wraith-chip/wraith-oss/docs/report.pdf

# WRAITH: A Resource-Efficient Dataflow Accelerator

ECE 427 Final Report

Prakhar Gupta
prakhar7@illinois.edu

Ingi Helgason
ingih2@illinois.edu

Pradyun Narkadamilli
pradyun2@illinois.edu

Sam Ruggerio
samuelr6@illinois.edu

Abstract—This work presents WRAITH, a compute substrate built on TSMC 65nm process that attempts to exploit available TLP and DLP in a power-efficient manner by colocating a set of “virtual” RISC-V processors and a dataflow accelerator on a shared datapath, as well as its bringup process.

I. PROJECT SUMMARY
A. Main Features
WRAITH contains a compute substrate consisting of 16 Processing Elements (PEs), arranged as a 4x4 2D mesh. 8 of these PEs are configured with 32-bit multipliers and 8 are configured with 32-bit ALUs (supporting most standard RISC-V ALU operations). Each PE can support up to 14 unique actions. A 2x2 subcluster PEs share a register file, with banked writes and all-way reads. There are two “scratchpad” banks, each 2KB, which hold the input and output results of kernel data respectively.
Two 5-stage RISC-V cores, implementing RV32IM are located near the compute substrate. Each core has a pipelined, 2KB, direct-mapped, shared I/D-cache. These cores utilize the compute mesh interface to perform multiplication. Provided the mesh is configured to handle RISC-V multiplications, this action can be performed even if the compute mesh is currently processing a kernel. These RISC-V cores share a 6-cycle 32-bit divider to fully implement the M specification.
All elements of WRAITH are managed by the Mesh and Memory Management Unit (MMMU). The MMMU handles a 32-bit tri-state bus from an off-chip controller and responds to memory requests from the RISC-V cores. When the off-chip controller is ready to utilize the mesh, it utilizes a cooperative protocol to receive the kernel for the mesh, along with the kernel input data itself. The MMMU also handles CSR read and write requests to inspect the functional state of the chip. WRAITH fits onto a 1mm²
square tile using a 65nm
process. It can support clock speeds up to 500MHz from an external clock, with some test features limited to 200MHz.
B. High-Level Architecture
The WRAITH architecture is depicted in Figure 1. At the center is a CGRA-like mesh of processing elements (PEs). Typical CGRA architectures tend to follow the ADRES [1] scheme, where each PE has a separate PC and executes its own program stored in a private configuration RAM. Care must be taken in the configuration to ensure cycle-by-cycle correctness during execution.
By contrast, WRAITH adopts a reactionary model for its mesh. Rather than operating on a sequential program, PEs

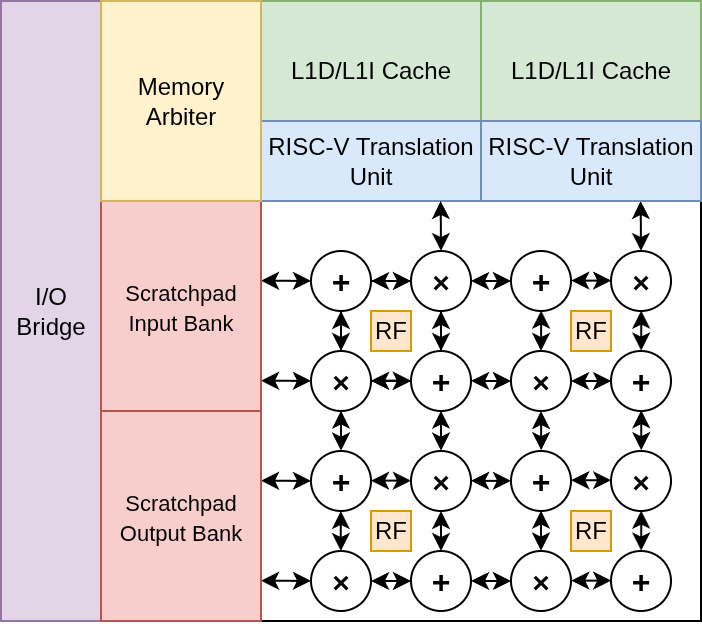
[picture p1: figure]

Fig. 1. WRAITH Architectural Diagram

instead generate responses to packets received from any of their neighboring nodes. The protocol for doing so is described in section IV-B. Both execution and configuration tasks for a PE are initiated by sending it a packet, meaning WRAITH’s mesh does not need any explicit control logic.
Control logic is instead managed by two controller peripherals, the MMMU and a Scratchpad Memory controller. These blocks work together to format input data and requests into a format ingestible by the ingress ports of the mesh.
Below, we give more detailed architectural descriptions of the various components utilized by WRAITH.
Processing Elements: Each processing element is a 3-stage pipeline which takes an input packet from a 2-depth FIFO, performs an operation, and generates an output packet to a 2-depth FIFO. See Figure 2 for a high level diagram.
The PE supports basic forwarding to mitigate data hazards, and has stall controls if the destination egress FIFO is full during operation. The multiplier supports 32-bit signed and unsigned multiplication, compliant with the RISC-V M specification. The ALU supports all standard RV32I operations except for slt and srl.
Each PE is connected to up to 4 adjacent PEs, with boundary PEs being connected to either the input/output scratchpad banks or the RISC-V cores for multiplication. The layout is a checkerboard of ALU and Multiplier PEs.
RISC-V Translation Units: WRAITH is equipped with two RISC-V “Translation Units” (RVTU). Each RVTU is a stan-

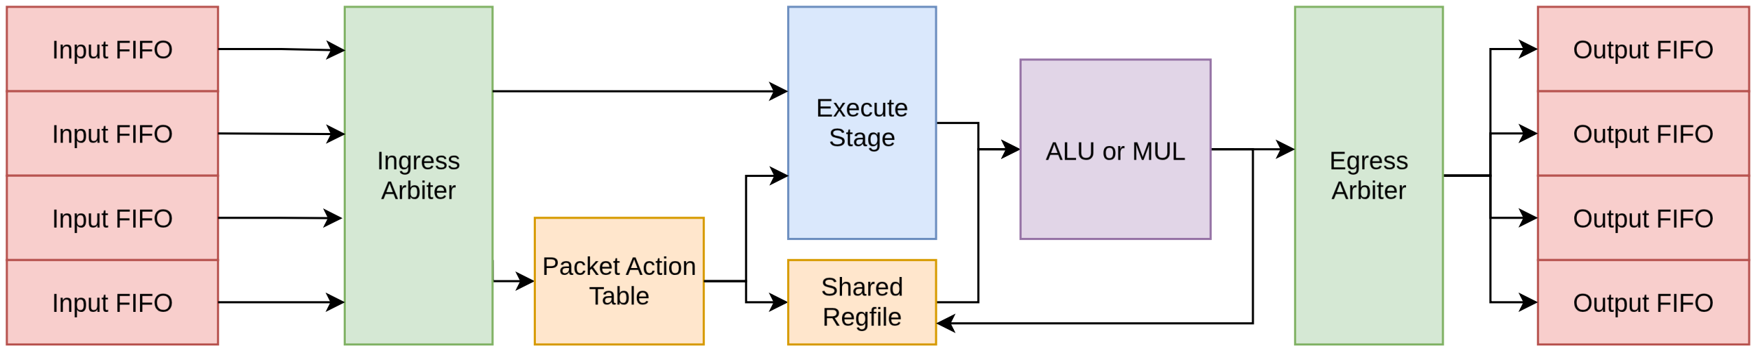
[picture p2: figure]

Fig. 2. Processing Element Pipeline

dard 5-stage pipeline core implementing RV32IM. However, in the Execute stage, a multiplication µOP is translated into two packets compliant with our mesh architecture. These packets are injected into the mesh and the RVTU awaits a response. This is our main proof of concept to show viable reuse of the compute mesh during low utilization. For completeness of the M specification, we included a 6-cycle 32-bit divider that is shared between the two RVTUs. See Figure 3 for the modified execute stage and shared cache changes.
Each RVTU has a pipelined, 2KB, direct-mapped, shared I/D-cache. These caches do not support triggered cacheflushes, as it is expected that this is done in software due to their small size. The user is expected to keep the memory sections of each RVTU’s program separate to avoid collision, as caches are not coherent.
Each RVTU also has a dedicated IO reset pin, and a halt CSR to indicate program completion. The reset pin also serves as a disable pin of sorts, as the RVTU will not emit any requests to any shared resources if it is held high. Scratchpad Banks: WRAITH contains two 2KB banks which handle input and output kernel data between the off-chip controller and the compute mesh. The off-chip begins a request by setting up CSRs to tell the scratchpad controller which PE to send and expect data from, how many packets are being set, and what PID should be used when sending the packets into the mesh. Kernels can operate on up to 512 32-bit words.
By default, the scratchpad controller is responsible for adding the PID to the input data, which determines whether the mesh is being configured or utilized. There is an alternative mode to reduce the bit-depth of the packet payload and include mixed-PIDs in the 32-bit word.
Once the scratchpad controller has received the correct number of packets, the off-chip controller can trigger a writeback to flush the output scratchpad bank. Provided that the kernel does not require pre-loaded constants each run, once the mesh is programmed once, the off-chip controller can send multiple cycles of data in succession.
Mesh and Memory Management Unit: The MMMU handles the memory requests from the RVTUs, the scratchpad banks, and the off-chip controller in a cooperative protocol. The MMMU controls a 32-bit tristate bus, polling specific pins to receive requests from off-chip. The MMMU contains an arbiter which manages bus access contention between the RISC-V cluster, the CSR file and the scratchpad banks.

Additionally, the MMMU manages two sets of CSR register files: one written to by on-chip and read by off-chip, and one read by on-chip and written to by off-chip. CSR requests are given priority over kernel operations, which is given priority over RVTU requests.

C. Physical Design
WRAITH utilizes a 1mm²
tile using TSMC’s 65nm process. There is a single clock domain which drives both the IO ring and internal modules. WRAITH supports clock speeds up to 500MHz, with some testing features limited to 200MHz. The standard IO ring allots a 820 × 820µm core area. We were able to expand our core area to 844 × 844µm with four 34×34µm triangular corners blocked for place and route. This increased our usable area to 710024µm²

from 672400µm²
Before filling, we utilize 547602µm²
core area, resulting in
77% density. A general view of our physical design can be seen in Figure 4, while the triangular blockage we used can be seen in Figure 5.
Our estimated power usage at a 500MHz clock, with a 1.0V core voltage:
- 158.4mW Internal Power
- 122.9mW Switching Power
- 255.2mW Leakage Power¹

Our IO utilization is as follows, for a total of 52 pins:
- 32 pins for the inout tri-state bus
- 2 pins for RVTU resets
- 6 pins for Scratchpad Bank “fallback” mode
- 3 pins for inspecting the IO Bridge FSM state
- 1 pin for power indication
- 2 pins for clock & reset
- 6 pins for power & ground pairs.
D. Design Choices

Reactive Mesh Architecture. CGRAs which adhere to the ADRES architecture [1] have a configuration RAM in each processing element to determine what operation to do next. Although this allows for more complex data orchestration paradigms, it would have been infeasible to implement in an area-efficient manner within the time constraints. Our reactionary model vastly simplifies implementation details and routing overhead, albeit at the cost of scheduling flexibility.

1This does not include leakage induced by our register file IP blocks, as the analysis reports 42W of leakage, which is erroneous.

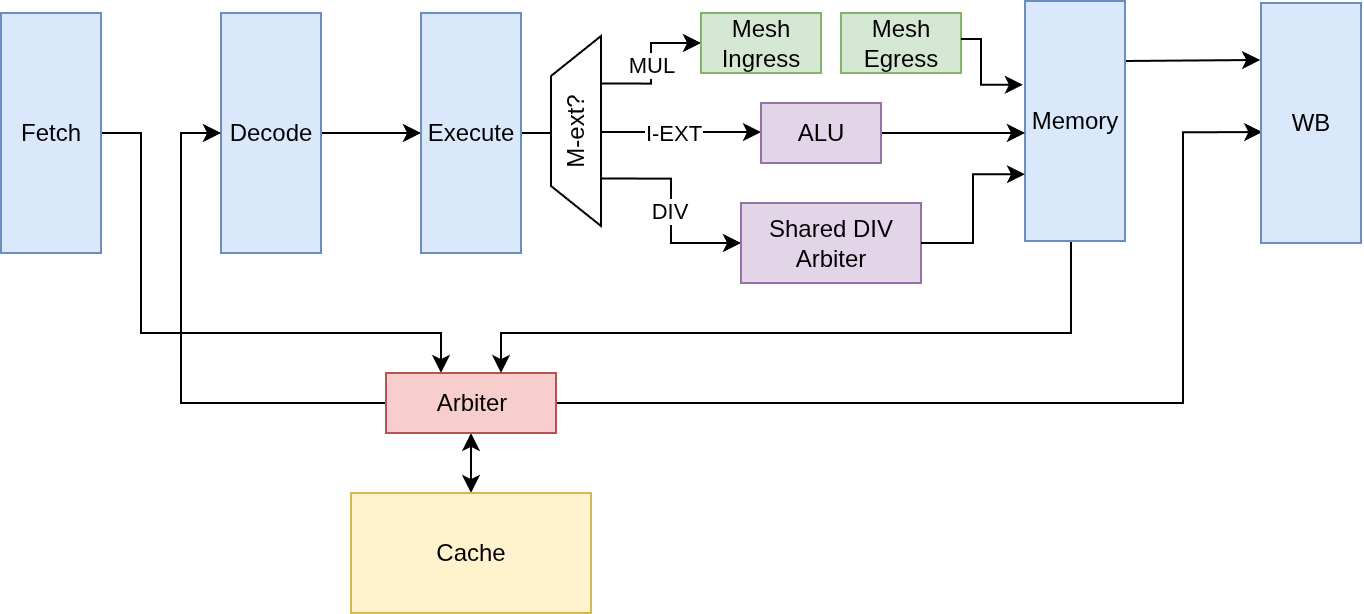
[picture p3: figure]

Fig. 3. RISC-V Translation Unit

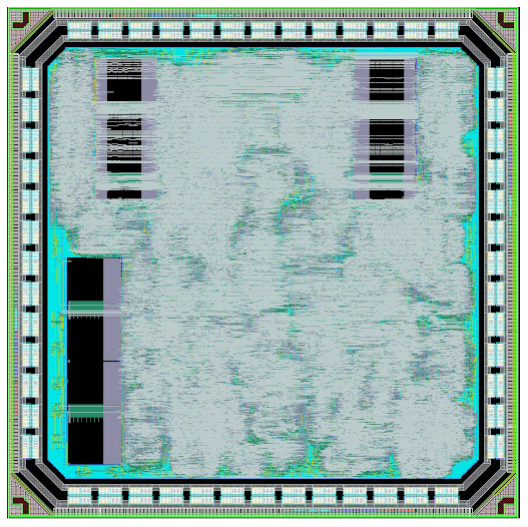
[picture p4: figure]

Fig. 4. WRAITH Chip physical layout, with metal layers 7-9 hidden.

Packet Translation. One possible method to reuse multipliers in the mesh would be a top-level configuration switch on a processing element dedicating it to the CPU, effectively removing it from the mesh. We decided that it would be more flexible to translate multiplication instructions into mesh packets. This consumes 5 of the PAT entries within the corresponding PE, however the alternative would be to completely remove it, so we feel that this was a better middle ground. RVTU Caches. We chose a shared I/D cache with 128 entries of 128 bits each due to size constraints and minimum supported configurations of the IP generator. We wouldn’t be able to make a reasonably smaller cache for a dedicated instruction cache without running into routing issues. 128 entries is the minimum number of entries one can generate using ARM’s IP generators.
Split Scratchpad Banks. Common scratchpad architectures in literature for CGRAs is usually one unified scratchpad cache

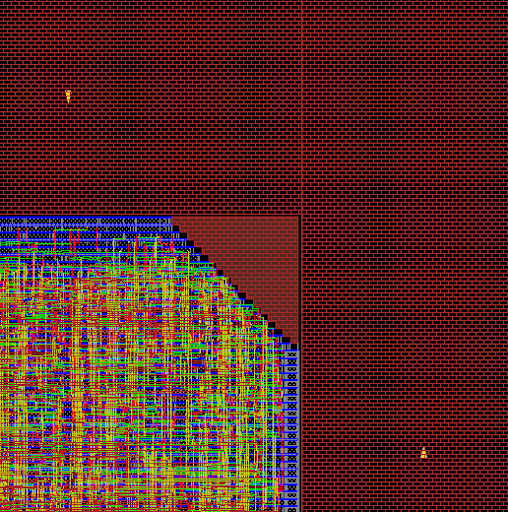
[picture p5: figure]

Fig. 5. A closeup of the corner blockage which permits expanded core area.

which handles both input and output data. Due to the reactive nature of our mesh and wanting to simplify the memory bus protocol as much as possible, we opted to split our scratchpad banks into dedicated input and output banks. This simplified the Scratchpad to Mesh interconnect without needing large crossbars to support entry from any PE.
32-bit Bus. We realized that with CSRs, we needed very few IO pins to configure our chip. This allowed us to make use of a full 32-bit bus which gives substantial speed improvements to loading kernel data and handling RISC-V cachelines.
E. Verification & Test Strategy
We verified our design using block-level test benches, and a sophisticated top level test bench which completely simulates an off-chip controller to configure and run kernels on the mesh and run programs on the RVTUs.
We have a PE test bench which verified the configuration and functional output of each PE, PE subcluster, and mesh over the course of several test cases. We have an RVTU test bench which verifies the RVTUs with a RVFI interface and Spike, along with the shared divider and mesh interface. Finally, our top level test bench configures and runs a mesh, whilst handling memory requests from both RVTUs simultaneously, with RVFI and Spike verification.
The top level testbench has several asynchronous tasks, that snoop the bus and react to requests made by the RVTUs. It also has a contention mechanism for all the potential off-chip drivers (CSR Write, SPM Write, Cacheline Response), so as to verify pseudo-random order of accesses. The top level test bench also has a Post-PnR version which runs on the compiled netlist of our design. This catches timing violations as well as functional correctness after synthesis and Place and Route. We have reserved some IO pins for DFT features of our chip during bring-up. Notably, we have 3 pins which connect directly to the MMMU’s IO Bridge to inspect the current state of the controller FSM. We also have 6 pins to stream packets in and out of the compute mesh, bypassing the scratchpad banks or IO bridge in the event of unforeseen failure. This is a rudimentary protocol which takes in a packet over 36 clock cycles and writes it out over 36 clock cycles. We also have a single pin to indicate successful power delivery. These control pins were false pathed in analysis, but we estimate we can utilize them at speeds up to 200MHz without timing violations.
F. Initial Proposal Differences

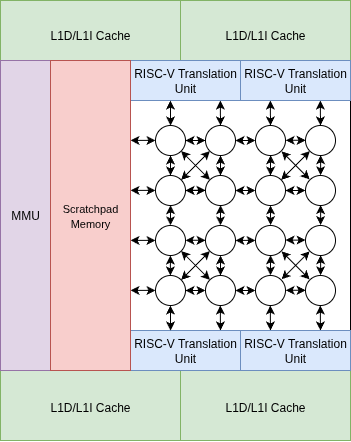
[picture p6: figure]

Fig. 6. Initial WRAITH Architectural Diagram

Our initial proposal diagram can be seen in Figure 6. We had to make a few simplifying changes due to area constraints. The largest one was our reduction of four cores to two, due to the limitations we had generating smaller caches and generally lack of total available area. We split our scratchpad banks to reduce crossbar area and simplify the logic between the mesh and the IO bridge.
We also simplified our mesh topology, initially each 2x2 subcluster had an all-to-all connection, but we reduced it down to be entirely 2D. In part, this change was done due to moving from having small, private register files within each PE to a shared regfile among a subcluster. We also had 4-depth FIFOs connecting each PE, but consumed far too much area, so we reduced it to a 2-depth PE.
We also simplified the intended use of the mesh during RVTU execution, limiting it down to just multiplication. In the future, we hope that with larger area we can support more RISC-V operations within the mesh with a lower latency. Not all changes were simplifications however, we were able to increase our IO bus from 16-bit to 32-bit, as we moved to using CSRs for most control features. We also added support for varying PIDs to support generation of non-linear kernel routing.
Additionally, we were initially planning clock speeds of 100-200MHz, but were luckily able to meet synthesis/PnR timing closure with a clock frequency of 500 MHz.

II. BRINGUP & RESULTS

Our chip was successfully taped out and packaged in a QFN64 9mm package. We were able to communicate with the chip and run test programs at speeds up to 125 MHz with a supply and I/O voltage of 1.8V.

A. PCB

To facilitate high speed communication between our driver FPGA and WRAITH, we designed a custom PCB with a direct FMC+ connector and a test socket (see Figure 7), to ensure shorter traces for bus signals. Our board is a 4 layer stackup, utilizing microstrip traces for signals. Our bus and clock signals are length matched within 56-61mm, and minimizes via use when possible. This ensures that the total incurred delay through trace length alone is bounded by 250ps. We empircally measured the trace delay on our PCB for a 56mm trace to be 245.4ps. Our traces are impedance controlled at 50Ω.
The voltage of the FMC+ connector is configurable with the System Controller utility or using an on-board EEPROM (24LC02B). We believe that this is not a strict requirement of such systems, as the System Controler UI is a convenient tool most groups will likely use in some capacity. In much of our testing, we used the System Controller for more immediate control over the FMC+ interface.
Additionally, we included a load switch on the main power line to WRAITH, so we could programmatically enable and disable power to the chip if we needed to ensure a cautious power up sequence. Finally, we have a single LED connected to our power indication pin on WRAITH.
We include a TPS22917x load switch component and use a power enable signal generated on the FPGA to further prevent unexpected power on. We opted to not use “power good” signals (see: VITA 57.x specification) for this, due to limited reference designs or explanation of how these signals should be used in power-on circuitry.

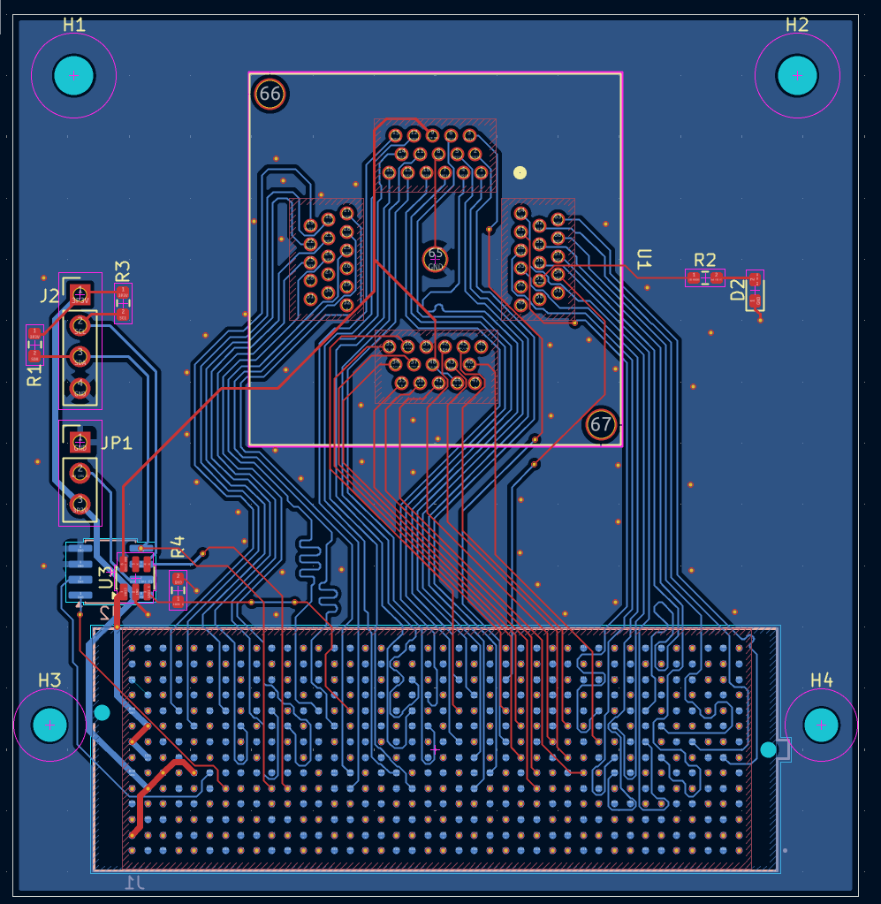
[picture p7: figure]

Fig. 7. CAD Diagram of our PCB

B. Husk

We designed an FPGA master to handle RVTU memory requests, programming and using the mesh fabric, and configuring on-chip CSRs. We will refer to this harness as “Husk”. Husk is meant to represent a standalone SoC that can both perform useful work (acting as a P core) and orchestrate transactions and configuration for WRAITH.
As the VCU118 FPGA does not contain a dedicated CPU core, we instead instantiate a RISC-V MicroBlaze softcore controller. Practically speaking this is not powerful enough for any useful computation. However, having a softcore allowed us to write a driver and test programs in C, interactively issue WRAITH transactions and configuration commands over UART, and abstract away hardware complexities when writing test vectors.
The majority of our development in bringup centered around developing Husk’s bridge controller. This performs all of the major functionalities required to implement WRAITH’s data bus protocol, service RVTU memory requests, issue and capture CSR requests and responses, and perform SPM transactions. Husk defers much of its hardware-aware logic into internal FSMs, simplifying the programmer-side view of WRAITH into the interface in Figure 9.
The bridge controller consists of 3 major components that could not be supported by standard Xilinx IP:
- An adapter to convert AXILite requests into blocking requests in the bridge controller’s address space
- An FSM to convert AXILite adapter’s requests into a sequence of low-level R/W commands to WRAITH
- A mirror of the data bus FSM on WRAITH and related controller logic to manage CSR transactions, RVTU memory requests, and SPM copy-in/out requests
These functions can be triggered by performing R/W requests to a 4KB address space set aside for CSR mappings – though in practice, we only use 64B and ignore the high address bits. CSR read/write commands within this address space map to R/W commands sent to the bridge controller. These initiate nonblocking requests to WRAITH from Microblaze’s perspective (to prevent stalling the AXI crossbar and softcore). Writes complete fully asynchronous of MicroBlaze execution, while reads can later be observed through a holding buffer in the MMIO space.
RVTU memory transactions require no intervention from the MicroBlaze, as the third FSM (WRAITH bridge mirror) implements logic to interface with onboard RAM blocks to service memory requests. Ultrascale RAM (URAM) blocks are used rather than typical BRAM or Distributed BRAM to accommodate the 512K memory size required to fit our test suite’s program images. These RAMs are dual-ported and mapped into the MicroBlaze’s AXI bus. To prevent saturating the MicroBlaze’s limited LMB (i.e program RAM), it is recommended that WRAITH’s URAM images be flashed by streaming in programs over UART through the appropriate driver command, rather than baking ELFs into the Microblaze program image.
Similarly, Husk contains a dual-port 2KB BRAM to be used as a scratchpad buffer. This is memory mapped into the MicroBlaze as well. In this case, the suggested control flow is to copy configuration or input data into the BRAM via memcpy, then write to the corresponding SPM CSR to request a copy transaction to WRAITH. When the data bus controller is able to service this request, it will use its own BRAM port to stream out data.
As mentioned earlier, the bridge controller is interacted with via a memory-mapped pseudo-CSR space. This consists of:
- SPM Control CSR: Handles reading from BRAM0 and sending it to WRAITH, or requesting finished kernel data and writing it to SPM, and clearing status registers, wrapped as one transaction.
- Busy CSR: Indicates whether the bridge is currently transacting on the bus, updating WRAITH CSRs or SPM data
- CSR output buffer: Holds the value of the last requested CSR from WRAITH.
- Meta Control: Toggles resets for WRAITH and the RV-TUs on WRAITH.
The meta control is used to ensure a safe power-on sequence for WRAITH. Specifically, we wish to hold WRAITH in reset until we are able to guarantee that the bridge controller has reset safely, and we can also use it to soft-reset WRAITH should we encounter any unforeseen errors during runtime.
C. Testing
The first priority of testing was low-speed verification of the tristate bus. Throughout the design, the bidirectional I/O (and accompanying protocol) of WRAITH presents the largest challenge.
While a standalone FPGA-based harness without the MicroBlaze SoC was planned and attempted, the end-to-end

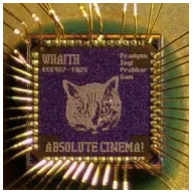
[picture p8: figure]

Fig. 8. Dieshot of WRAITH

verification tooling was successfully completed first, and thus was used.
1) Startup: After loading the ELF to the MicroBlaze, we manually assert the system-wide reset to ensure correct behavior with our CDC registers. We use the AMD System Controller to configure VADJ to 1.8V. Finally, we write 0x1 to the “meta” CSR to deassert the reset on WRAITH.
2) Running Kernels: Our MicroBlaze program has kernels baked in, and invoked via a single command. The order to run these manually is the following:
1) Write to the SPM Config CSR settings for programming the configuration. This requires the ingress select to be set to 0, PID select to be set to 0, and PID ID to be set to 0.
2) Write the SPM Configuration data to the BRAM and trigger a write-out.
3) Write to the SPM Config CSR settings for programming the constants. This requires the ingress select to be set to 0, PID select to be set to 0, and PID ID to be set to 1.
4) Write the SPM Constants data to the BRAM and trigger a write-out.
5) Write to the SPM Config CSR settings for the kernel data. All settings are determined by the specific kernel that is programmed.
6) Write the Kernel data to the BRAM and trigger a write-out.
7) Poll the SPM status register until the kernel has finished, and trigger a write-back.
It is not recommend to do polling actions in a pure spin loop, as each action triggers a request on the bridge, starving other requests WRAITH may make. A small delay will ensure that other consumers are permitted to use the bridge .²
D. Engineering Challenges

There were many engineering challenges, minor and major, during the project. We highlight the primary ones we felt unable to address, and try to provide germane advice.

2
In practice, the delay from the CDC prevents this from happening, though in a tighter coupled system a proper interrupt scheme would be used.
1) PCB Design: One major issue we encountered in our first PCB revision was incorrect orientation of the FMC+ connector, caused by the misinterpretation of a visual aid present in the documentation. To avoid this, we encourage groups to verify with the real board, using their CAD software’s 3D viewer if possible. We also suggest ordering and installing the connector prior to the arrival of the chips, as we only noticed this discrepancy when inspecting the evaluation board. Additionally, working to impedance-control (via width control, per vendor-provided values) and length-match PCB traces increased the time and effort during this phase. We did not perform testing such as TDR (Time Domain Reflectometry) to ensure the accuracy of our impedance match, and so do not make claims about the accuracy of the impedance match. However, we were able to length match the traces quite well, and successfully use connector I/O up to a modest frequency, as discussed previously.
Importantly, despite minimal on-board skew and propagation delays for these signals, we were ultimately significantly limited in the frequency we were able to verify by sub-par placement of the chip I/O with respect to the VCU118’s I/O banks. This was due to the fact that the “LA” Bank is split over I/O banks 41 and 43, while the “HA” Bank is mapped into bank 70 (geometrically opposite corners of the die). Since our data bus protocol requires changing tri-state direction on the cycle after seeing a request go high on the input pins, we are required to route the request pin to the register closest to the IOBUFs of every other DBUS pin to facilitate this direction switch.
Despite our initial intuition, this delay across banks significantly dominated that of the PCB. The routing delay from bank 43 to 70 is approximately 4ns on the VCU118, which is an exceptionally powerful FPGA. These delays could have larger effects on other older or lower performance FPGAs. This delay is also significantly higher than that of our PCB traces, which were empirically found to be approximately 0.25 ns.
Due to the state transition logic attached to the input pins of the data bus, our maximum frequency during testing was limited to 125 MHz. We suspect that this issue will be less pressing in designs with split unidirectional channels, and that we can likely push frequency higher with another board revision to reassign package pins to FMC+ pins.
In light of our own struggles, we suggest that for course designs targeting high frequencies, students extensively review I/O assignments, taking care to consider routing factors (on custom PCB), FPGA I/O properties and constraints, additional design constraints (e.g. bidirectional or “loop” constraints on chip inputs/outputs), electrical properties (to not place signals too close to each other), and which pins may not be easily accessible (due to incomplete implementation of the full FMC+ connector specification by Xilinx in their provided development board), to list a few. Opting to use bidirectional I/O acts as a multiplier on the relevance of these concerns. Finally, while minor, we suggest that groups may wish to deliberately short the TDI and TDO pins provided on the FMC+ connector if not intending to use the JTAG functionalities: this allows continued use of the board’s JTAG connector after the installation of the mezzanine card. This issue did not have significant effects on our design, but we mention it as something which may help improve the testing process 3
2) Instrumentation (Husk): The design of the MicroBlaze SoC, Husk, presented some design challenges. The most significant is that of clock domain crossing. In order for us to guarantee that the MicroBlaze SoC was able to safely synthesize while we pushed frequency higher, we were required to decouple the clock of the block design (MicroBlaze and its peripherals) and that of the fabric logic (e.g Bridge Controller). This led to a significant increase in complexity as a result of several clock domain crossing channels between AXI IP and our own fabric logic.
Something that we discovered later in testing is that the Xilinx crossbar IP is capable of facilitating clock domain crossings for you – as a result, we strongly urge future groups with complex bringup SoC designs to write all of their logic on a single clock domain, and pass their fabric clock/reset inputs into the MicroBlaze block design. This will allow you to interface with any URAMs (which are shared-clock even on true dual port settings) or AXI-facing IP without needing asynchronous FIFOs or complex toggle crossings.
Another challenge of note is the practicalities of verifying a complex block design. It may not be possible to simulate all of the block design reliably. As a result, our group favored directed testing for the bridge controller alone, but complex tests requiring coordination with the MicroBlaze or AXI fabric were done on-FPGA with debug cores to verify functionality. The VCU118’s exceptionally large size allowed us to tap a number of nets even while clocking the softcore platform at 300MHz.
Finally, reiterating the importance of pin assignments, ensure that the DDR4 interface chosen has pin mappings close to the rest of the chip’s I/O – lack thereof can cause design placements with large gaps between SoC logic and chip-facing logic, which can/will cause timing failures past 50MHz. In practice, we found that the C1 DDR4 interface is much more amenable to high-speed designs with FMC+ than that the C2 DDR4 interface, which has its pin routing on rows Y1-Y3 (as opposed to C1’s Y12-Y14).
3) Discovered Bugs: We identified one bug which emerges when certain CGRA kernels are programmed and executed in succession. A single piece of stale data gets written out first, causing an off by one error. The cause of the bug was not fully identified, but we determined a strategy to avoid this bug during operation, either by requesting a flush of a the kernel by one packet or resetting WRAITH. This bug was later identified in behavioral simulation. During design verification, we only tested one type of kernel programmed at a time between resets. Notably, under the same kernel, multiple passes of constants and data can be sent without issue.

3We covered the “present” pin on the FMC+ connector, which prevented opening the JTAG chain when the board was inserted. This pin should be pulled to ground, and TDI-TDO shorted.

E. Advice to Future Groups

Our greatest challenge during the bringup process was with work distribution and coordination of responsibilities, verifications, and deliverables. Most of our challenges came from a lack of tacit knowledge; that is, we found it hard to proactively identify and communicate about limitations or concerns between levels of the chip-bringup stack.
These decisions require extensive consideration throughout tapeout, FPGA harness design, and PCB design. The main ways we suggest future groups to avoid these challenges are:
1) To start even earlier than feels necessary;
2) To take extreme care to compensate for the amount of time and “inevitable errors” you will encounter;
3) Extensively communicate with the other and current course groups to ensure you can identify as many relevant engineering concerns as possible

III. MAJOR DESIGN CHALLENGES

A. Post-PNR Testing

Our verification methodology definitely required significant engineering effort during the Post-PNR phase. While the behavorial testbench was fairly stable it did not account for metastability and timing path delays in a design backannotated with the SDF timing annotations. This led to several bugs that were time-consuming to solve, and made debugging difficult, as it was impossible to know if the simulation was failing due to issues with the design, or the testbench.
1) wait: The systemverilog wait keyword evaluates before NBAs for every time event in the VCS simulator. As such, the wait would evaluate on ”stale” signals, leading to the testbench following an incorrect flow. Hardcoding a sanity check with a fixed delay as a ”hotfix” did not work either due to metastability in FSM state registers. As such it took quite some effort to determine a correct alternative.
2) Thread Starvation: The Post-PNR testbench utilized a multitude of fork join tasks. Some of these were cacheline handlers, which would be invoked at the start of the sim, and would snoop/drive the bus to service RVTU cacheline requests, and process cacheline flushes, while contending with other tasks for the bus. Due to direct-mapped nature of the RVTU caches - most of the bus traffic was for cacheline requests. The tasks for this, would always win arbitration for the bus. As such, the other tasks that checked mesh completion by polling the CSRs would be starved of the bus, significantly increasing the simulation runtime. As such, adding a wait of a random duration between 1 - 64 cycles to the main loop of the cacheline request handler task, enabled a more fair utilization of the memory bus.
B. ARM SRAM Generation/Import

The SRAM generator had some rough edges, and we consistently experienced issues when importing into Cadence Virtuoso. This necessitated repeated SPICE netlist corrections, which were done through a mixture of processing scripts

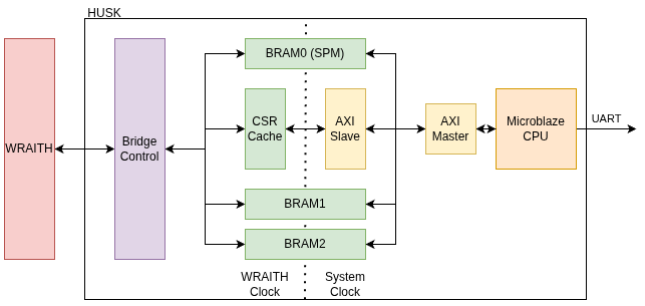
[picture p9: figure]

Fig. 9. Block Diagram of Husk

and manual adjustments where necessary. We had to rewrite an existing replace.py script due to its compatibility with the Regfile-type Physical IP, which we chose due to its smaller sense amplifier and increased synergy with our design properties.

C. Kernel Mapping and Development
One of our greatest limitations, partially due to scheduling, was the difficulty of modeling and mapping a variety of kernels to our architecture. These limitations are primarily imposed by data permanence issues that can come with subsequent packets overwriting old data in the register file and the single-inputstream model imposed by a unified SPM.
While we cannot support concurrent kernel execution, data permanence is mitigated via a modulo register file scheduling scheme. As our architecture supports varying PIDs, in the kernel configuration and data encoding we rotate PIDs for data bitstreams (for example, cycling through 8 distinct PIDs). By doing so, we can ensure adjacent packets access and write to different register file indices without any clobbering concerns. The exact number of PIDs required to cycle through varies based on the maximum effective pipeline depth of an expressed kernel, and the age of the intermediate results it requires. In practice, we have found success with naively implementing windowing schemes (like for convolution of any 3-wide filter) or imposing relevant constraints on the kernel to reduce required data lifetimes (1D convolution with an 8-wide filter, but only if it has real roots).

IV. DOCUMENTATION
This section discusses the design and properties of the major components of WRAITH. The high-level architecture is discussed in Section 1.B, and a diagram of these components are shown in Figure 1.
A. Memory Bus
As previously discussed, WRAITH requires a large amount of memory transfer between itself and the off-chip components of its surrounding system. Our design reuses a 32-bit wide tristate bus for handshake and data, in order to avoid using dedicated “in” and “out” buses. This allows an almost 1 word/cycle data rate for both input and output operations, despite the limited number of signal I/O pins available (48). The communication protocol used is somewhat inspired by the PCI “Legacy” bus protocol, where only the essential signals are carried over (namely: CLK, and a subset of AD[31:0]’s single address and numerous data lines). Other key features, such as the REQ# and GNT# signals, are functionally reproduced by requiring a tighter degree of coupling/cooperative interaction. For instance, device requests (for memory read/write) are broadcast using the unified addressdata lines. Arbitration between requests initiated by WRAITH and the off-chip host occurs according to a predefined format for bus requests: as such, no explicit grant signal is required, as devices assume the request priority order and shall not contend for access to the tristate bus.
1) Limitations/Challenges: Before discussing our implementation of this specification, we would like to note here that this design possess some consequences: some which we anticipated, and others which were not initially clear. First and foremost, our interface is inherently limited to the assumption that the bus possesses no more than two bus controllers; as such, this memory bus places limitations on the systems in which WRAITH can be used. The introduction of certain control overheads along with the high clock rate of the signaling environment (due to the tri-state nature of the bus) also impose some restrictions on the nature of the testing environment.
Finally, the usage of a single data line led us to constrain memory transfers to being contiguous rather than in the form of several temporally-distinct “packets” (as can be accomplished in other protocols such as AXI4-Stream). As such, the “pinned memory requirement” typical of certain processoraccelerator integrated systems obtains a somewhat stronger form, wherein memory must be coalesced in a buffer with constant/predictable lookup in order to program the WRAITH device. Note that this issue can be somewhat sidestepped by the usage of multiple programming phases, at the cost of increased runtime consumed by programming/configuration tasks.
Unforeseen physical design considerations led us to make RTL modifications late into the design phase, in order to account for the potential for shorts on bus acquisition/release not noticed during protocol design. The revised protocol is presented here, which we believe does not suffer from (or minimally, is significantly less prone to) shorting/bus contention issues. As such, the authors do not necessarily recommend the re-creation of this system, instead offering it up for study. Regardless, the bus protocol is functional and verified (both behaviorally and post-PnR), and does accomplish its intended goal of providing a multi-master bus with minimal control pin overhead. The following section will describe the protocol we settled on.
2) Memory Bus Protocol: For subsequent discussion, on-chip shall refer to any request initiated by the WRAITH chip, while off-chip shall refer to any request initiated by the off-chip host.
The WRAITH system, together with its host core, require the implementation of 8 distinct message types, which can be seen in Table I.

TABLE I
WRAITH MEMORY BUS MESSAGE TYPES
Message Type | Description | Code
| Requests initiated by off-chip host
Scratchpad Memory Write | Write to scratchpad memory to provide kernel configuration or data. Length de-termined by CSR value. | 2
CSR Write | Write a value to a WRAITH control and status register. | 5
CSR Read Request | Request to read a WRAITH control and status register value. | 3

Requests initiated by WRAITH
Scratchpad Memory Write-back | Write full kernel output to off-chip host. Length configured by CSR value. | 1
Cacheline Read Request | Request to read cacheline contents from off-chip host memory/cache. | 8
Cacheline Writeback | Write back dirty cacheline contents mod-ified by WRAITH. | 6

Response types
CSR Read Response | Initiated by WRAITH. Contains value of last requested CSR. | 7
Cacheline Read Response | Initiated by off-chip host. Contains previ-ously requested cacheline contents. | 4

The flow between states is determined entirely by the message type. In order to reduce logic depth around tristate drivers, WRAITH currently exhibits a static priority for off-chip requests; however, the logic described is fully functional if code or message type is used to perform message selection. The states required in order to handle these two message types (that is, the state machine associated with WRAITH’s memory bridge) is summarized in Figure 10.
With regards to WRAITH-driven data, the on-chip logic used to determine which requests/address/data to send (that is, after the grant is obtained) is best discussed elsewhere. However, we note here that the memory controller performs arbitration between the different sources and types of on-chip

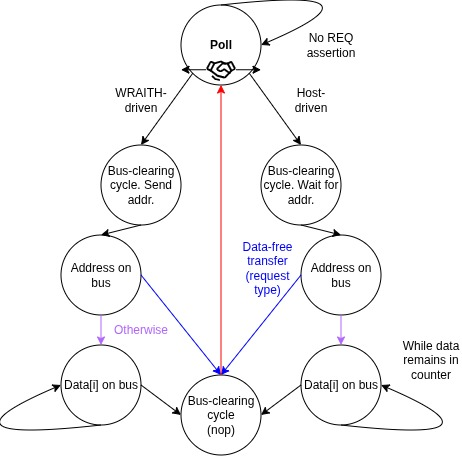
[picture p10: figure]

Fig. 10. WRAITH: Memory bus states

requests, such that WRAITH presents only one request during any given “poll” cycle.
The protocol described above is ultimately used to provide the interface pictured in Figure 11 to on-chip components, which is the interface exposed to the on-chip caches, as well as to the scratchpad memory controller.
B. WIMP
WRAITH’s mesh implements the WRAITH Interconnect Mesh Protocol (WIMP). WIMP dictates packet format, configuration/response format and routing control for the mesh and its peripherals.
All packets in WRAITH are single-beat to maintain consistency and simplify implementation details. A packet is comprised of two fields:
1) A 4-bit Packet ID (or PID)
2) A 32-bit immediate value
All WRAITH PEs implement a register-immediate scheme – that is to say, any operation is done purely by taking one register and the mesh immediate as inputs to the FU. The FU output is then used as the immediate for an output packet. By looking at the PID, WRAITH is able to determine what operation to perform and how to generate a response packet. This is done by indexing into a PE Action Table (or PAT) with the PID. The format of a single PAT entry is shown in Table II, with a graphical representation in figure 12.
It should be noted that despite WRAITH only having 4 possible output directions, dest is made 3-bit to accommodate an additional SINK direction. This allows some operations, like a load-immediate from an RVTU or spacer packet, to terminate with a side effect but no spurious output packet.
As routing logic is encoded by the PAT configuration but writing the PAT configuration is determined by routed packets, there is a bit of a catch-22 on initial reset to program the mesh. To avoid this, a bypass routing mechanism is implemented specifically for PIDs 0 and 1. Each PE in the mesh is assigned

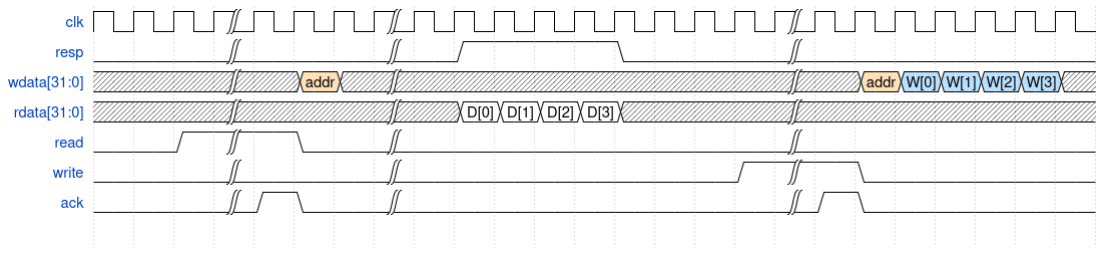
[picture p11: figure]

Fig. 11. On-chip Interface

TABLE II
WIMP PAT ENTRY FORMAT
Field Name | Description | Bitwidth
response_pid | What PID to tag the output packet with | 4
dest | Which direction to send the packet to | 3
src | Index into the RF for input value | 5
rd | Index into the RF to write output | 5
rf_we | Write enable to register file port | 1
imm_we | Write the packet immediate directly to the RF | 1
src_imm | Interpret src as an immediate | 1
fu_op | Function select for instantiated FU | 3

a coordinate from 0 to 15. This bypass network expects packets to be inputted at the top left node, passes a packet to the right until in the correct column, then downwards until the destination is reached.
PID 0 is always allocated for writing an entry into the PAT. Its packet immediates are formatted as shown in Figure 12, and will always spawn a response of PID 0.
Some kernels require hard-coded constants in the register file to operate correctly. Thus PID 1 is allocated for a “constant load” operation, and formats its packet immediates as shown in Figure 12. These packets are also routed via the bypass network.
C. Processing Elements
There are a total of 16 Processing Elements within WRAITH. 8 support standard ALU operations, while the other 8 support multiplication. Each 2 × 2 subcluster of PEs share a 32-entry register file. Each PE can write to 8 entries in the register file, but can read from all 32 entries. As seen in Figure 2, each PE is connected to up to 4 ingress FIFOs, and outputs packets to egress FIFOs, all of which are 2-depth. The Ingress Arbiter is a simple round robin arbiter to dequeue a packet from one of the available ingress FIFOs.
This packet is then used to supply the 32-bit immediate to the execute stage, and index into the Packet Action Table, as described in Section I-B. The next stage of the processing element utilizes the functional unit, whether it be an ALU or multiplier. The output is then registered into the 3rd stage, which is pushed into an egress FIFO.
If a FIFO is full, the PE will stall until it becomes available to push through. It will not backfill or process other packets which don’t depend on the full FIFO. It will however, support forwarding over the register file if the PE is reading and writing to the same entry.
The operations for the ALU are as follows, where a is the packet immediate and b is the register value:
Option | Operation
0 | a + b
1 | a << b
2 | a >>> b
3 | a − b
4 | a ⊕ b
5 | b
6 | a | b
7 | a & b
TABLE III
PE ALU OPERATIONS

The ALU is given an identity mode to act as a passthrough value for b. This is used for windowing operations in some kernels (like convolution) in conjunction with the PAT’s imm_we option. The multiplier supports standard RISC-V format, mul, mulh, mulsu, mulhu, as well as the identity function. Two multiplier PEs are connected to the RVTUs, to provide direct handling of the RISC-V multiplication instructions. Two PEs are connected to the input scratchpad bank, and 2 PEs are connected to the output scratchpad bank.

D. RISC-V Cluster
WRAITH has a RISC-V cluster, depicted in figure 13, consisting of two RISC-V translation units (RVTUS).
These are for the most part standard RISC-V cores that support the RV32IM ISA, and are built to fit a typical 5-stage pipelining scheme with static branch pessimism and forwarding to mitigate data hazards. To simplify logic design and verification efforts, a ”global stall” approach is taken, where the pipeline can only progress once all pipeline stalls have been resolved. This includes cache access stalls, multicycle execute operations and bubble insertion on consecutive memory instructions.
Notably, RVTUs do not inherently contain the logic to compute M-extension instructions – rather, they dispatch this logic to other shared resources via the interfaces depicted in figure 3.
For divide support, the RISC-V cluster comes with a shared 6-stage sequential divider. Divider access is managed by a round-robin arbiter, which provides a port to each pipeline.

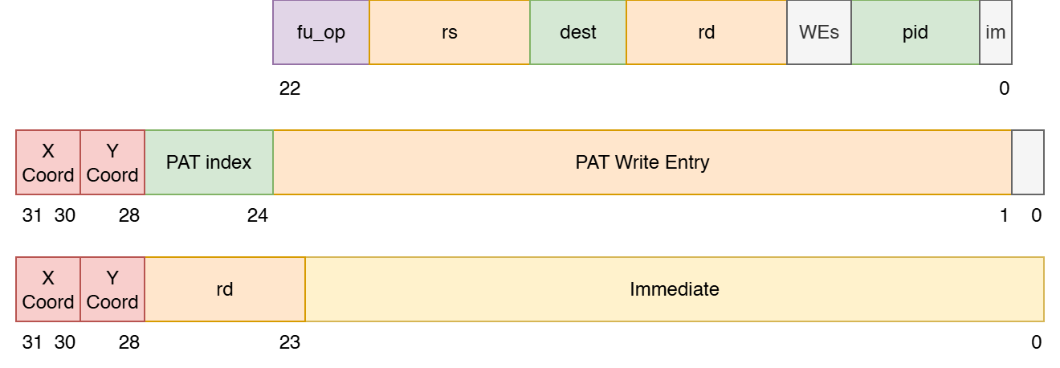
[picture p12: figure]

Fig. 12. Above: PAT Write Entry Format. Middle: Configuration Packet. Lower: Constant-Load Packet.

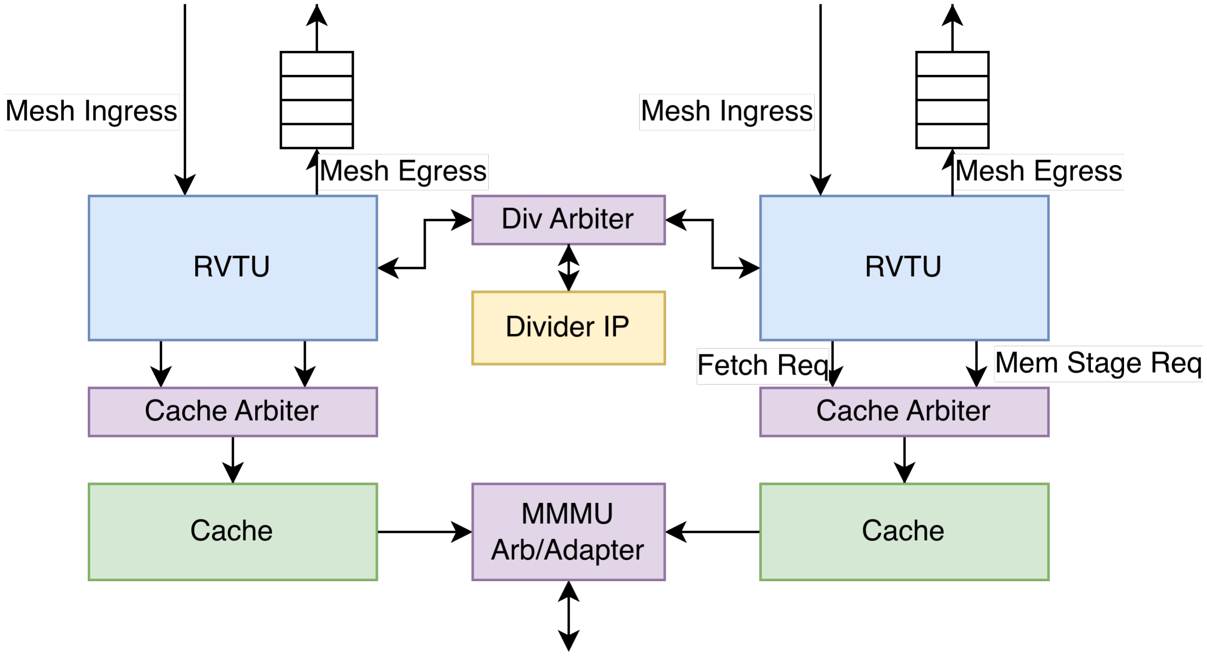
[picture p13: figure]

Fig. 13. RISC-V Cluster Diagram

This arbiter accepts divide operands and an operation select from each pipeline’s execute stage, and broadcasts the completion status of the divider IP once the operation has completed. To comply with global stall semantics, the arbiter is aware of when the pipeline associated with an outstanding request is stalling, and will maintain the result and valid signals on its output until this stall is lowered. Furthermore, to ensure correctness of operation, dependencies on outstanding load instructions are monitored to guarantee that both inputs are ready and broadcasted on forwarding paths (as applicable) before initiating a request to the arbiter.
Multiplication is performed by co-opting MUL processing elements in the mesh via a set of dedicated mesh ingress/egress ports connected to the RVTU’s execute stage. To conform with convention for ingress ports, the RVTU instantiates a 2-deep FIFO to enqueue ingress packets into before consuming them. For each multiplication instruction, an RVTU will generate two packets to the mesh egress packet – one to transfer its first operand into one of the MUL PE’s register slots, and another to initiate the actual multiply instruction. This store operation is typically implemented as a multiply-by-1, where the 1 is a constant stored in the PE register file. This is done to facilitate a register-register instruction within the mesh’s register-immediate ISA. The MUL PEs response is sent to the RVTU’s ingress FIFO, where it is then dequeued and interpreted as an operation result once all other pipeline stalls have resolved.
To simplify logic, RVTU requests simply WIMP packets with no special properties – thus multiply support must explicitly be configured in the mesh’s kernel programming. During normal operation, this also means that if the RVTU is expected to run a program that has multiplication instructions, its reset pin should be asserted until programming completes. To facilitate sharing of the RVTU cache, a cache arbiter (CA) is attached to the fetch and memory stages of the pipeline. Priority is statically given to the memory stage, and it is assumed that there is always implicitly a request from the fetch stage. As both stages must have their requests fulfilled for the pipeline stall to go down, memory stage responses are buffered in a register stage. This register stage is tagged with a valid flag raised on cache response and lowered on the first cycle the pipeline stall drops. While this valid flag is asserted, the arbiter will ignore the request interface of the memory stage.
Both cache arbiters are then fed into a second-stage round-robin arbiter that manages access to the MMMU. This secondlevel arbiter accepts and services CA requests at the cache line granularity, but includes a burst adapter to convert CA requests to the MMMU’s on-chip memory protocol.
E. Processing Mesh Bitstream

Mesh bitstreams are typically encoded as three distinct sequences.
1) Configuration: The contents of each PE’s PATs, laid out linearly and tagged with the PE and PAT index they are associated with.
2) Constants: Any constants required by the program that are larger than 5 bits. These are laid out the same way as the configuration bitstream, albeit with a wider ”line index” (for the register file). Register indices must match the register file bank allocation of the stated processing element, as this bitstream facilitates a series of registerwrite operations.
3) Data: The input data for the mesh to operate on. Can be expressed as a sequence of 32-bit values, or as a sequence of 28-bit values tagged with a 4-bit PID specifier. The interpretation is determined by the PID_SEL CSR. As our system adheres to register-immediate operation, and input data is delivered via the immediate lines on the mesh, we are unable to provide constants greater than 5 bits intrinsically as part of the configuration bitstream. Thus the constant bitstream preloads register indices unused by the kernel with any required values for access at runtime. In practice, the constant bistream has been used to preload the mesh’s register files with filter constants when performing 1-D convolution. Each bitstream is sent over separate bus transactions. To simplify SPM and bridge handling, PIDs 0 and 1 were allocated for handling the configuration and constant bistream. The appropriate PID is indicated via CSR settings.
Typical execution semantics dictate programming the mesh with the configuration and constant bitstreams once, then delivering an arbitrary number of data bitstreams for execution. The mesh can be reprogrammed at any time (assuming no outstanding data transaction). It should be noted that if the chip is not being reset before programming, one must take care to either not overwrite dedicated RVTU PAT and register file entries in the new kernel, or assert the RVTU resets prior to reprogramming. There is no explicit restriction in place to enforce constant registers not being overwritten – if desired, this must be done by the kernel expressed in the configuration bitstream.
V. TESTING INSTRUCTIONS
A. Generating Mesh Bitstream
At the moment, all kernels must be hand-written – due to the novel nature of our mesh and the additional constraints imposed by RVTU configuration, there is no pre-existing compiler framework compatible with our chip. While a number of dummy kernels were flashed onto the mesh to test functionality, at the moment we do all full-system functional testing with a Conv3 kernel (convolution of some input data stream with a 3-wide filter). This is done with integers at the moment, but fixed-point constants can be supported via software in the future.
To | generate | the | bitstreams | for | Conv3, | run
cartographer/conv3_mapper.py. This will dump
a data bitstream into out.dat, a constant bitstream into out.const, and a configuration bitstream into out.cfg. A ”golden output” will also be printed to the terminal to verify runtime output against. A pregenerated set of Conv3 kernel bitstreams is available in
chip/hvl/top-verif/mem_files.
B. RVTU Simulation
The RVTUs are tested via several unit testbenches, the most relevant being rvtu_cluster_sim. This testbench instantiates the full RISC-V cluster, instantiates two autoconfigured MUL PEs, and has a memory model that emulates the timing of the MMMMU arbiter.
To run this testbench, go to chip/sim and run make
run_vcs_cluster_sim. This target takes PROG0 and

PROG1 arguments that configure which program to run on each core. This can be a C/C++, assembly or compiled program. A small assortment of provided testcases is available in chip/sim/testcode, with the Makefile defaulted to run Coremark on Core 0 and needle.cpp (Rodinia’s Needleman-Wunsch benchmark) on Core 1.
Do note that while using pre-compiled programs is supported, the linker script uses different static-mapped memory regions for each core to make a unified memory model more feasible. Using pre-compiled memory images for a core they it is not intended is very likely to quickly incur runtime errors. Each core is harnessed with an RVFI monitor for runtime correctness-checking, but will also dump commit logs
to chip/sim/vcs/{core0.log, core1.log}. These
can be diffed against Spike by running make spike_im PROG=<PROGRAM> to generate a golden log. The ELFs required to do so are dumped in chip/sim/memgen when running the main simulation target. The ELF’s name will be appended with the core number it was compiled for, and you will likely run into Spike mismatches if using the wrong ELF file.
C. Behavioral Full-System Verification

Note: For brevity, all paths listed in this section are relative to the /chip subdirectory.
After navigating to the sim directory, run make
vcs/top_tb and make run_vcs_top_tb. Running so
converts 2 RVTU programs in the $PROG[0,1] paths to memory maps. Do note that these paths are set by default in the Makefile.
The | testbench | also | ingests | the | files | in
chip/hvl/top-verif/mem_files/ directory, namely
[cfg,cnst,data]_mem.hex. These files represent the bitstreams for the configuration, constant and data streams for the Mesh.
This simulation also consumes the files in the memgen folder, which contains a memory map for the RVTU memory space (generated by compiling the program files mentioned earlier).
Lastly, the outputs of the behavioral sim can be observed in vcs/simulation.log. Additionally, the output memory maps (SPM WB data stream, final RVTU memory map) can
be found in vcs/spm_wb.dmp and rvtu_wb.mem in the hvl/top-verif/mem_files/ directory.
The SPM Writeback can be diffed against a golden output in the hvl directory. Similarly, the RVTU memory transaction logs can be diffed against logs in the groupdir (namely,
/groups/ece427-group0/rvtu_memlogs/).
D. Post-PNR Full-System Verification
After | navigating | to | the | chip/sim | directory,
run | make vcs/post_pnr_tb | and | make
run_vcs_post_pnr_tb
After navigating to the chip/sim directory, run make
vcs/top_tb and make run_vcs_top_tb.

This testbench uses the same variables/paths as the Behavioral FSV testbench, with an additional path to the SDF file used for back annotation. This SDF file is expect to be in the synth/pnrout/ directory with the name top.pnr.sdf.

E. Post-Silicon Verification
Upload the bitstream to the VCU118, and compile and upload the test program from Vitis. If the low-speed bitstream is being used, then open the System Controller and set the VADJ to 1.8V (this is the default).
Connect over UART at 9600 buad, a command prompt will appear with instructions to run various test programs. With test programs that utilize the RVTUs, it will be necessary to upload the memory-map of the programs over UART.

VI. INDIVIDUAL CONTRIBUTIONS - DESIGN & VERIFICATION
- Prakhar
– Scratchpad Memory/Controller RTL & Verification – IO Bridge Communication & CSR definitions
– PE Mesh Verification
– Full-System & Post-PnR Verification
- Ingi
– MMMU Bridge and Arbiter RTL & Verification – PD/PnR Flow, Scripting, Tooling
– LVS Scripting, Closure & Signoff
- Pradyun
– System Architecture
– PE/Mesh Architecture, Simulator & RTL – RVTU Cluster RTL & Verification
– MMMU Bridge RTL
– Full-System & Post-PnR Verification
– Kernel Mapping/Design & Bitstream Generation
- Sam
– PE/Mesh RTL & Verification
– RVTU Cache RTL
– PD/PnR Flow, Closure & Signoff
– Miscellaneous tooling & local tool execution

VII. INDIVIDUAL CONTRIBUTIONS - BRINGUP
- Prakhar
– PCB Layout, Routing, Assembly
– Husk Verification (AXI-Lite Bridge)
– Driver Code for Microblaze SoC
– WRAITH direct-testing harness RTL – Chip Testing
- Ingi
– PCB Schematic, Assembly
– Husk Verification (Bridge Simulation) – WRAITH direct-testing harness RTL
– Chip Testing
- Pradyun
– FPGA Platform Architecture & SoC Integration
– Husk RTL (AXI-Lite Bridge, WRAITH Controller)

– Husk Verification (Controller, Full-system)
– CGRA Mesh Directed Tests & Kernel Mapping – Driver Code for Microblaze SoC
– Chip Testing, FPGA Synthesis & Timing Closure
- Sam
– PCB Layout, Routing, Assembly
– Husk Verification (AXI-Lite Bridge)
– Chip Testing
– UART interface & Driver Code for Microblaze SoC

VIII. ACKNOWLEDGEMENTS
We would be remiss without thanking all the people and structures that helped us complete this project.
Thank you to Milos Becvar, our mentor, for providing valuable guidance and sanity-checks during an admittedly frantic development cycle.
Thank you to Stanley Wu and Jerry Wang for offering all manner of support throughout this project. Your experience was invaluable in avoiding common pitfalls and making a feasible design.
Finally, thank you to Apple, the University of Illinois and Professor Dong Kai Wang for giving us this opportunity. Taping out a chip as university students is an extremely rare opportunity and helped us build invaluable experience pursuing future careers in this field.

REFERENCES
[1] B. Mei, M. Berekovic, and J-Y. Mignolet. “ADRES & DRESC: Architecture and Compiler for Coarse-GrainReconfigurable Processors”. In: Fine- and Coarse-Grain Reconfigurable Computing. Ed. by Stamatis Vassiliadis and Dimitrios Soudris. Dordrecht: Springer Netherlands, 2007, pp. 255–297. ISBN: 978-1-4020-6505-7. DOI: 10 . 1007 / 978 - 1 - 4020 - 6505 - 7 6. (https://doi.org/10.1007/978-1-4020-6505-7_6) URL: https://doi.org/10.1007/978-1-4020-6505-7 6.
