wraith-chip/wraith-oss/husk/custom_ip/husk_axi_port_1_0/drivers/husk_axi_port_v1_0/src/husk_axi_port.h

#ifndef HUSK_AXI_PORT_H
#define HUSK_AXI_PORT_H


/****************** Include Files ********************/
#include "xil_types.h"
#include "xstatus.h"

#define HUSK_AXI_PORT_S00_AXI_SLV_REG0_OFFSET 0
#define HUSK_AXI_PORT_S00_AXI_SLV_REG1_OFFSET 4
#define HUSK_AXI_PORT_S00_AXI_SLV_REG2_OFFSET 8
#define HUSK_AXI_PORT_S00_AXI_SLV_REG3_OFFSET 12
#define HUSK_AXI_PORT_S00_AXI_SLV_REG4_OFFSET 16
#define HUSK_AXI_PORT_S00_AXI_SLV_REG5_OFFSET 20
#define HUSK_AXI_PORT_S00_AXI_SLV_REG6_OFFSET 24
#define HUSK_AXI_PORT_S00_AXI_SLV_REG7_OFFSET 28
#define HUSK_AXI_PORT_S00_AXI_SLV_REG8_OFFSET 32
#define HUSK_AXI_PORT_S00_AXI_SLV_REG9_OFFSET 36
#define HUSK_AXI_PORT_S00_AXI_SLV_REG10_OFFSET 40


/**************************** Type Definitions *****************************/
/**
 *
 * Write a value to a HUSK_AXI_PORT register. A 32 bit write is performed.
 * If the component is implemented in a smaller width, only the least
 * significant data is written.
 *
 * @param   BaseAddress is the base address of the HUSK_AXI_PORTdevice.
 * @param   RegOffset is the register offset from the base to write to.
 * @param   Data is the data written to the register.
 *
 * @return  None.
 *
 * @note
 * C-style signature:
 * 	void HUSK_AXI_PORT_mWriteReg(u32 BaseAddress, unsigned RegOffset, u32 Data)
 *
 */
#define HUSK_AXI_PORT_mWriteReg(BaseAddress, RegOffset, Data) \
  	Xil_Out32((BaseAddress) + (RegOffset), (u32)(Data))

/**
 *
 * Read a value from a HUSK_AXI_PORT register. A 32 bit read is performed.
 * If the component is implemented in a smaller width, only the least
 * significant data is read from the register. The most significant data
 * will be read as 0.
 *
 * @param   BaseAddress is the base address of the HUSK_AXI_PORT device.
 * @param   RegOffset is the register offset from the base to write to.
 *
 * @return  Data is the data from the register.
 *
 * @note
 * C-style signature:
 * 	u32 HUSK_AXI_PORT_mReadReg(u32 BaseAddress, unsigned RegOffset)
 *
 */
#define HUSK_AXI_PORT_mReadReg(BaseAddress, RegOffset) \
    Xil_In32((BaseAddress) + (RegOffset))

/************************** Function Prototypes ****************************/
/**
 *
 * Run a self-test on the driver/device. Note this may be a destructive test if
 * resets of the device are performed.
 *
 * If the hardware system is not built correctly, this function may never
 * return to the caller.
 *
 * @param   baseaddr_p is the base address of the HUSK_AXI_PORT instance to be worked on.
 *
 * @return
 *
 *    - XST_SUCCESS   if all self-test code passed
 *    - XST_FAILURE   if any self-test code failed
 *
 * @note    Caching must be turned off for this function to work.
 * @note    Self test may fail if data memory and device are not on the same bus.
 *
 */
XStatus HUSK_AXI_PORT_Reg_SelfTest(void * baseaddr_p);

#endif // HUSK_AXI_PORT_H
